byQ96/Scorpio-recruit/sprawozdanie/spr.pdf

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

## 1 Wst¦p

Jestem studentem III roku Automatyki i Robotyki na wydziale Elektroniki, interesuj¦ si¦ motoryzacj¡, elektronik¡, robotyk¡ oraz najnowszymi technologiami, np Przemysªem
4.0. Moim pierwszym projektem opartym na mikrokontrolerach byª system alarmowy oparty na czujnikach PIR. Braªem udziaª w warsztatach robotycznych organizowanych przez KoNaR, podj¡ªem si¦ budowy robota MiniSumo, odkªadana w czasie budowa niedawno zako«czyªa si¦ sukcesem. Od roku uczestnicz¦ w KN EKSA, gdzie grupowo realizuj¦ projekt Systemu Detekcji Wyªadowa« Atmosferycznych, gdzie do przetwarzania danych i komunikacj¡ z serwerem u»ywamy pªytki Nucleo z procesorem STM32. Na co dzie« du»o zajmuj¦ si¦ elektronik¡ i bardzo interesuje mnie Wasz projekt ªazika, dlatego chciaªbym si¦ sta¢ jednym z jego twórców.

## 2 Realizacja

Podj¡ªem si¦ realizacji zadania 2. dla elektroników/programistów. Czyli zaprojektowania schematu i pªytki PCB zgodnie z wytycznymi.

### 2.1 Schemat ukªadu

Omawianie schematu pozwol¦ sobie rozdzieli¢ na kilka cz¦±ci, zgodnie z wytycznymi i wªasnymi spostrze»eniami.
Sercem prototypu pªytki jest 100 nó»kowy procesor STM32F107V C. Wybraªem go z powodu mo»liwo±ci obsªugi systemu wymiany danych CAN oraz ETHERNET'u.

2.1.1 Podstawowe rzeczy

Przyj¡ªem »e ukªad b¦dzie zasilany warto±ci¡ 12V. Oczywi±cie warto±¢ t¡ mo»na zmieni¢, jednak maksymalna warto±¢ napi¦cia wej±ciowego nie powinna przekracza¢ 15V. Nie dodaªem »adnego zabezpieczenia elektronicznego przed odwrotn¡ polaryzacj¡, zast¡piªem je zabezpieczeniem mechanicznym - gniazdo zasilania jack. Dodaªem zielon¡ diod¦ zasilania, oraz przycisk do resetu ukªadu.

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



2.1.3 IMU

Zdecydowaªem si¦ na poªo»enie ukªadu LSM9DS1 bezpo±rednio na pªytce. Uwa»am, »e niew¡tpliw¡ przewag¡ takiego rozwi¡zania jest stabilno±¢ ukªadu i lepsza dokªadno±¢ wskaza« ni» przy zastosowaniu gotowej pªytki z moduªem do wlutowania, która mo»e nie by¢ wystarczaj¡co sztywna i zakªamywa¢ wskazania. Jak wida¢ na schemacie czujnik posiada mo»liwo±¢ zmiany adresu akcelerometru/»yroskopu oraz magnetometru. (ustawiaj¡c odpowiednio zwork¦ mo»emy ªatwo wyª¡czy¢ z dziaªania który± z moduªów. Moduª podª¡czony jest do mikroprocesora za po±rednictwem magistrali I2C.

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

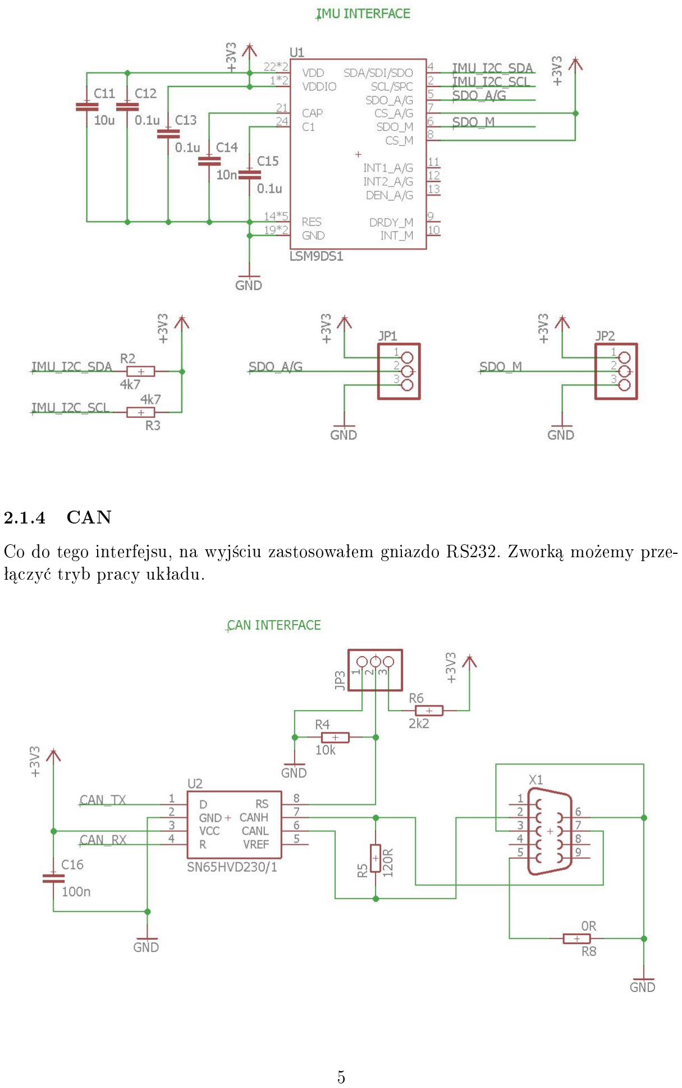
[picture p18: page 5]

2.1.5 Enkoder Absolutny

Sporo czasu zaj¦ªo mi wybranie odpowiedniego interfejsu, na pocz¡tku chciaªem podª¡-czy¢ enkoder na przerwania, jednak ostatecznie zdecydowaªem si¦ na poª¡czenie po SPI. Zalet¡ takiego rozwi¡zania jest mo»liwo±¢ podª¡czenia kilku enkoderów do tej samej linii danych. Gniazdo jakie wyprowadziªem to 6-pinowy goldpin ustawiony pod k¡tem prostym, pasuje on do enkoderów absolutnych marki Bourns, model:EMS22A, który zostaª zaprojektowany dla zasilania 3.3V, ale b¦dzie pracowaª prawidªowo równie» z innymi enkoderami z mo»liwo±ci¡ obsªugi SPI.


2.1.6 Ethernet

Ten moduª jest najbardziej rozbudowany. Do budowy schematu u»yªem ukªadu DP83848, wzorowaªem si¦ natomiast na gotowym module ZL3ET H. Ukªad posiada oddzieln¡ ltracj¦ zasilania, kwarc taktuj¡cy zegarem 25MHz, który mo»na zmieni¢ w zale»no±ci od typu u»ywanej transmisji. Na wyj±ciu ukªadu znajduje si¦ gniazdo RJ-45 z dwoma diodami stanu, które pokazuj¡ wysyªanie/odbieranie danych.


2.1.7 Fototranzystor, dioda IR, dioda LED, gniazdo programatora

Fototranzystor podª¡czyªem do wej±cia ADC1 mikroprocesora, próbkuj¡cego sygnaª analogowy. Dioda IR podª¡czona pod gniazdo z obsªug¡ PWM. Tak samo równie» zwykªa dioda LED stanu podª¡czona pod generator PWM. Nie wiem czy dobrze zrozumiaªem zadanie, ale wszystkie 3 elementy usytuowane s¡ w jednym miejscu na pªytce. Diod¦ IR mo»na wi¦c ustawi¢ nad fototranzystorem, tranzystor jako sprz¦»enie zwrotne b¦dzie generowaª sygnaª PWM na diodzie LED. Wi¦c teoretycznie sygnaª PWM na diodzie LED powinien odpowiada¢ temu wygenerowanemu na diodzie IR.
Gniazdo programatora jest dodatkiem ode mnie. Stwierdziªem i» dodanie zwykªego goldpinu mogªoby by¢ do±¢ uci¡»liwe przy ci¡gªym wpinaniu i wypinaniu wtyczki, dlatego zastosowaªem gniazdo miniUSB.


2.1.8 Przyciski i diody LED

Poniewa» przy mikroprocesorze zostaªo sporo wolnych pinów zdecydowaªem o umieszczeniu dodatkowych 3 przycisków oraz 3 diód LED w kolorach (zielonym, »óªtym, czerwonym). Mog¡ si¦ one przyda¢ np. do pokazywania ró»nych stanów pªytki, usterek czy awarii, natomiast przyciski do zmieniania ustawie«.

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


### 2.2 Projekt PCB

Zaprojektowana przeze mnie pªytka jest dwuwarstwowa. W projekcie u»yªem opcji Autoroutera, który poprowadziª dla mnie ±cie»ki w 80 procentach, reszt¦ naniosªem r¦cznie. Wersja studencka programu, której u»ywaªem, nie pozwalaªa na zwi¦kszenie wymiarów obszaru roboczego powy»ej 10 cm x 8 cm. cie»ki zasilania s¡ pogrubione, elementy ltruj¡ce staraªem si¦ umieszcza¢ jak najbli»ej ukªadów scalonych.


Rysunek 1: Górna warstwa

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



Rysunek 3: Poª¡czenie warstw

Poni»ej wstawiam zdj¦cia prototypu w 3D, jakby to wygª¡daªo wizualnie po zªo»eniu, na spodzie znajduje si¦ tylko kilka elementów, które przeszkadzaªy na górnej warstwie.

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

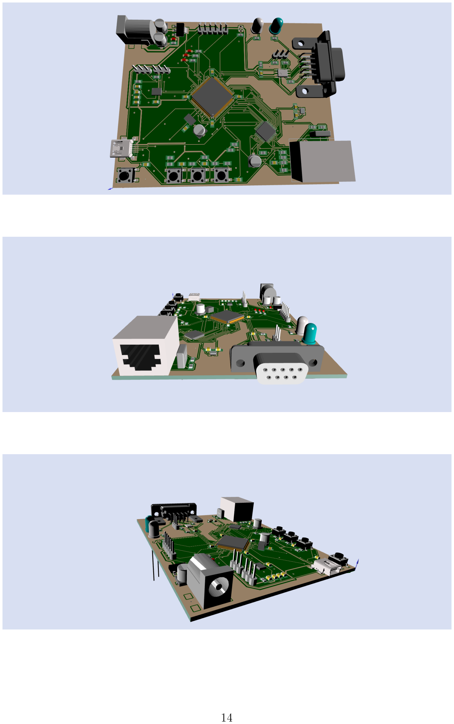
[picture p19: page 14]

### 2.3 Programowanie i prototyp

Poni»szy rysunek przedstawia konguracj¦ portów w programie Cube MX, do programowania u»yªbym biblioteki HAL.


## 3 Podsumowanie

Do sprawozdania zaª¡czam archiwum, w którym znajduj¡ si¦ elementy projektu - schemat poª¡cze« i projekt pªytki w formacie EAGLE'a, a tak»e biblioteki których u»ywaªem przy projektowaniu. Z racji braku czasu prototyp oraz programowanie pªytki s¡ kwesti¡ niedoko«czon¡. W razie potrzeby kontaktu ze mn¡ na temat projektu prosz¦ o kontakt pod poni»szy adres e-mail: michal126@hotmail.com.
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
