byQ96/Scorpio-recruit/sprawozdanie/figures/screenshot (2).png

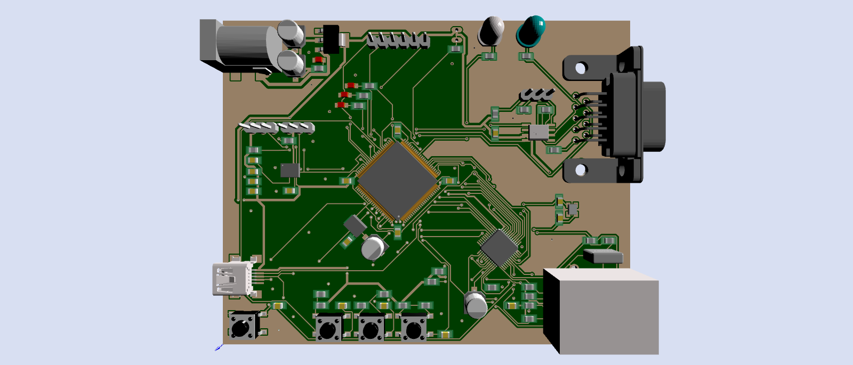
sprawozdanie/figures/screenshot (2).png
