byQ96/Scorpio-recruit/eagle/schemat1.brd

## EAGLE design eagle/schemat1.brd (2017-11-30)

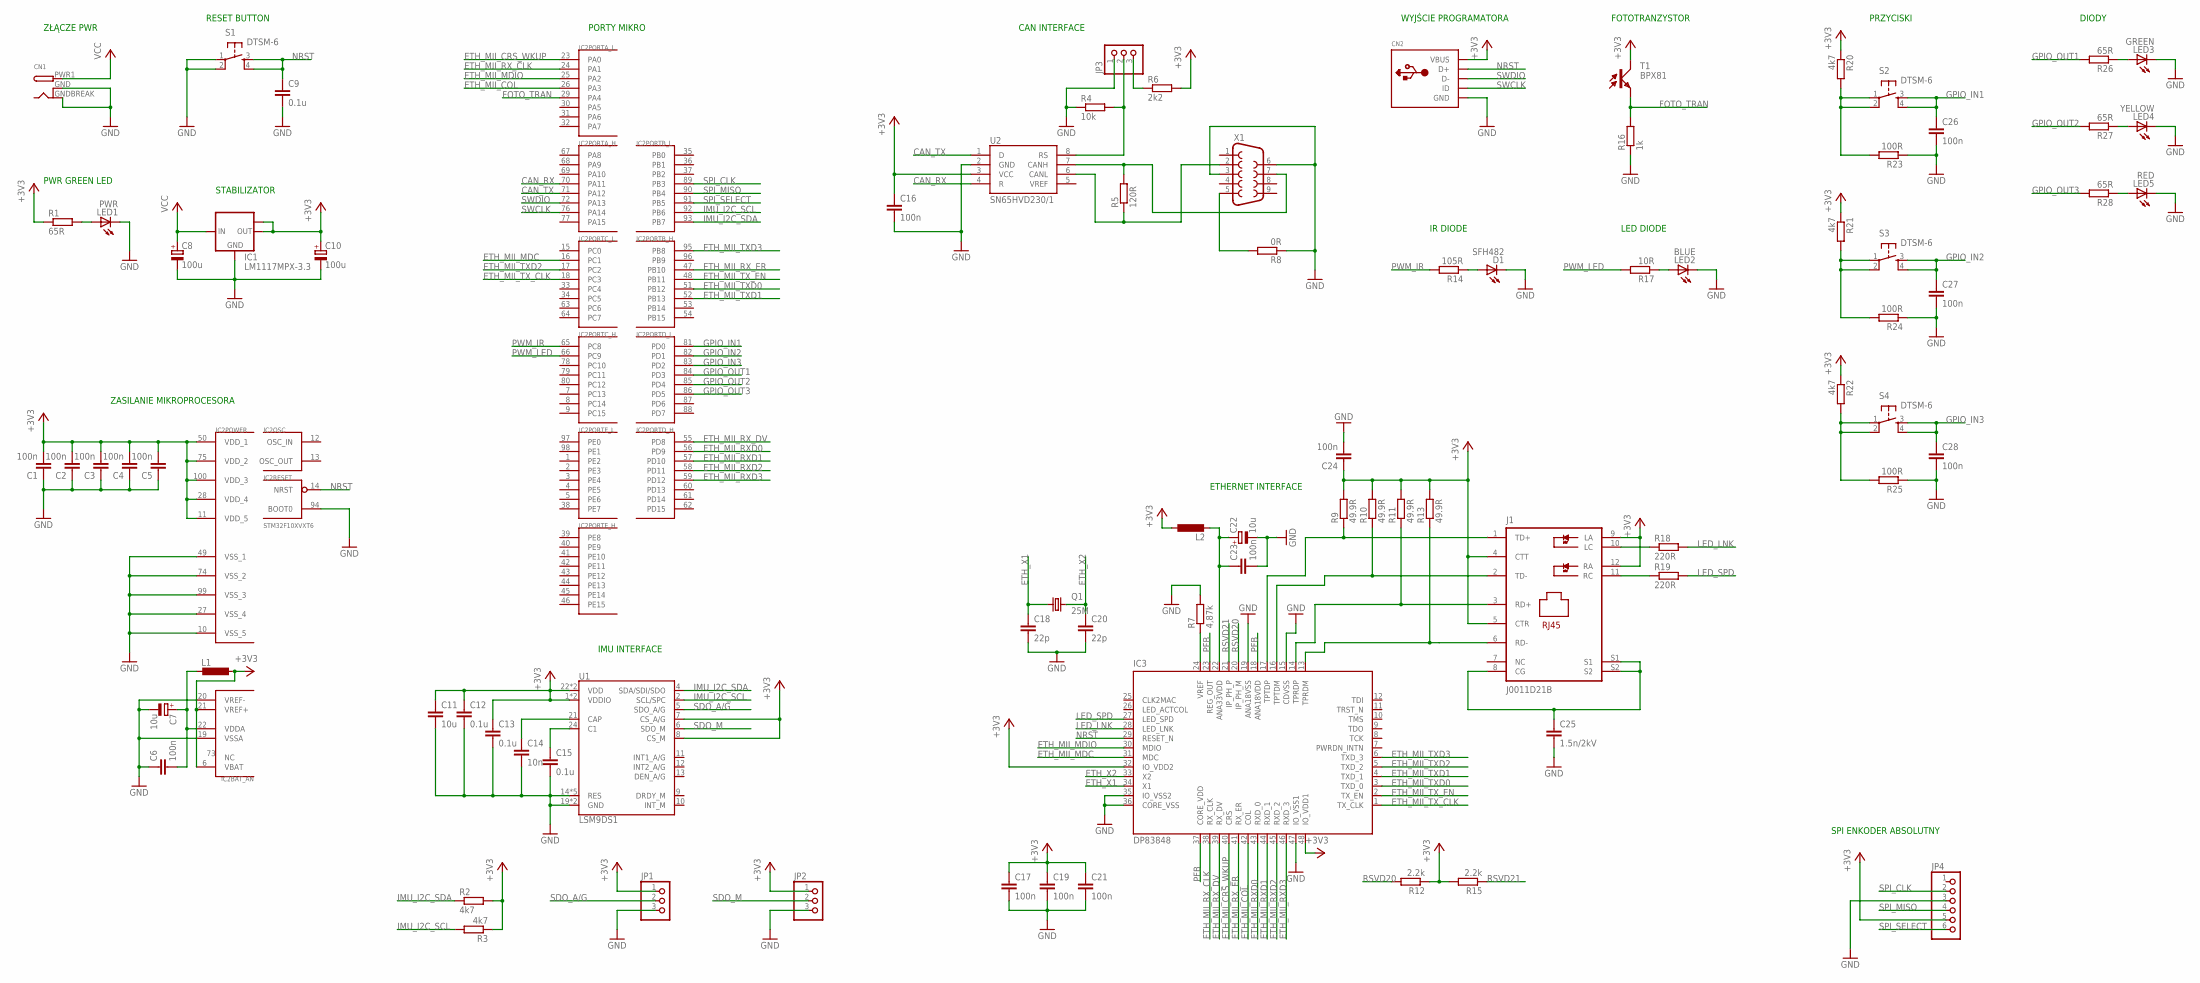
[picture p21: schematic schemat1.sch]

Parts:
C1, C2, C3, C4, C5, C6, C16, C17, C19, C21, C23, C24, C26, C27, C28: 100n; C0805
C7, C22: 10u; PANASONIC_C
C8, C10: 100u; PANASONIC_C
C9, C12, C13, C15: 0.1u; C0805
C11: 10u; C0805
C14: 10n; C0805
C18, C20: 22p; C0805
C25: 1.5n/2kV; C050-030X075
CN1: DCBARRELSMT; DCJACK_2MM_SMT
CN2: USBMINIB; USB-MINIB
D1: SFH482
IC1: LM1117MPX-3.3; SOT223
IC2: STM32F10XVXT6; TQFP100
IC3: DP83848; LQFP48
J1: J0011D21B; J0-A/B/F
JP1, JP2, JP3: PINHD-1X3; 1X03
JP4: PINHD-1X6/90; 1X06/90
L1, L2: L-EUL3230M; L3230M
LED1: PWR; CHIPLED_0805
LED2: BLUE; LED5MM
LED3: GREEN; CHIPLED_0805
LED4: YELLOW; CHIPLED_0805
LED5: RED; CHIPLED_0805
Q1: 25M; 3.2X2.5_KX-7
R1: 65R; R0805
R2, R3: 4k7; M0805
R4: 10k; M0805
R5: 120R; M0805
R6: 2k2; M0805
R7: 4,87k; R0805
R8: 0R; R0805
R9, R10, R11, R13: 49.9R; R0805
R12, R15: 2.2k; R0805
R14: 105R; M0805
R16: 1k; R0805
R17: 10R; M0805
R18, R19: 220R; R0805
R20, R21, R22: 4k7; R0805
R23, R24, R25: 100R; R0805
R26, R27, R28: 65R; M0805
S1, S2, S3, S4: DTSM-6
T1: BPX81
U1: LSM9DS1; LGA24-8X4
U2: SN65HVD230/1; SO8
X1: F09HP

Connections:
+3V3: C1.2, C2.2, C3.2, C4.2, C5.2, C10.+, C11.1, C12.1, C13.1, C16.1, C17.1, C19.1, C21.1, C24.1, CN2.VBUS, IC1.2 (OUT), IC1.TAB (OUT1), IC2.6 (VBAT), IC2.11 (VDD_5), IC2.21 (VREF+), IC2.28 (VDD_4), IC2.50 (VDD_1), IC2.75 (VDD_2), IC2.100 (VDD_3), IC3.32 (IO_VDD2), IC3.48 (IO_VDD1), J1.4 (CTT), J1.5 (CTR), J1.9 (LA), J1.12 (RA), JP1.1, JP2.1, JP4.5, L1.1, L2.1, R1.1, R2.2, R3.1, R6.2, R9.2, R10.2, R11.2, R12.1, R13.2, R15.2, R20.1, R21.1, R22.1, T1.C, U1.1 (VDDIO), U1.3 (VDDIO), U1.7 (CS_A/G), U1.8 (CS_M), U1.22 (VDD), U1.23 (VDD), U2.3 (VCC)
CAN_RX: IC2.70 (PA11), U2.4 (R)
CAN_TX: IC2.71 (PA12), U2.1 (D)
ETH_MII_COL: IC2.26 (PA3), IC3.42 (COL)
ETH_MII_CRS_WKUP: IC2.23 (PA0), IC3.40 (CRS)
ETH_MII_MDC: IC2.16 (PC1), IC3.31 (MDC)
ETH_MII_MDIO: IC2.25 (PA2), IC3.30 (MDIO)
ETH_MII_RXD0: IC2.56 (PD9), IC3.43 (RXD_0)
ETH_MII_RXD1: IC2.57 (PD10), IC3.44 (RXD_1)
ETH_MII_RXD2: IC2.58 (PD11), IC3.45 (RXD_2)
ETH_MII_RXD3: IC2.59 (PD12), IC3.46 (RXD_3)
ETH_MII_RX_CLK: IC2.24 (PA1), IC3.38 (RX_CLK)
ETH_MII_RX_DV: IC2.55 (PD8), IC3.39 (RX_DV)
ETH_MII_RX_ER: IC2.47 (PB10), IC3.41 (RX_ER)
ETH_MII_TXD0: IC2.51 (PB12), IC3.3 (TXD_0)
ETH_MII_TXD1: IC2.52 (PB13), IC3.4 (TXD_1)
ETH_MII_TXD2: IC2.17 (PC2), IC3.5 (TXD_2)
ETH_MII_TXD3: IC2.95 (PB8), IC3.6 (TXD_3)
ETH_MII_TX_CLK: IC2.18 (PC3), IC3.1 (TX_CLK)
ETH_MII_TX_EN: IC2.48 (PB11), IC3.2 (TX_EN)
ETH_X1: C18.1, IC3.34 (X1), Q1.1
ETH_X2: C20.1, IC3.33 (X2), Q1.3 (2)
FOTO_TRAN: IC2.29 (PA4), R16.2, T1.E
GND: C1.1, C2.1, C3.1, C4.1, C5.1, C6.1, C7.-, C8.-, C9.2, C10.-, C11.2, C12.2, C13.2, C14.2, C15.2, C16.2, C17.2, C18.2, C19.2, C20.2, C21.2, C22.-, C23.2, C24.2, C25.2, C26.2, C27.2, C28.2, CN1.GND (GNDBREAK), CN1.GNDBREAK (GND), CN2.GND, D1.K (C), IC1.1 (GND), IC2.10 (VSS_5), IC2.19 (VSSA), IC2.20 (VREF-), IC2.27 (VSS_4), IC2.49 (VSS_1), IC2.74 (VSS_2), IC2.94 (BOOT0), IC2.99 (VSS_3), IC3.15 (CDVSS), IC3.19 (ANA18VSS), IC3.35 (IO_VSS2), IC3.36 (CORE_VSS), IC3.47 (IO_VSS1), JP1.3, JP2.3, JP3.1, JP4.3, LED1.C, LED2.K (C), LED3.C, LED4.C, LED5.C, R4.1, R7.2, R8.1, R16.1, R23.1, R24.1, R25.1, S1.1, S1.2, U1.14 (RES), U1.15 (RES), U1.16 (RES), U1.17 (RES), U1.18 (RES), U1.19 (GND), U1.20 (GND), U2.2 (GND), X1.3, X1.6
GPIO_IN1: C26.1, IC2.81 (PD0), S2.3, S2.4
GPIO_IN2: C27.1, IC2.82 (PD1), S3.3, S3.4
GPIO_IN3: C28.1, IC2.83 (PD2), S4.3, S4.4
GPIO_OUT1: IC2.84 (PD3), R26.2
GPIO_OUT2: IC2.85 (PD4), R27.2
GPIO_OUT3: IC2.86 (PD5), R28.2
IMU_I2C_SCL: IC2.92 (PB6), R3.2, U1.2 (SCL/SPC)
IMU_I2C_SDA: IC2.93 (PB7), R2.1, U1.4 (SDA/SDI/SDO)
LED_LNK: IC3.28 (LED_LNK), R18.2
LED_SPD: IC3.27 (LED_SPD), R19.2
unnamed: IC3.13 (TPRDM), J1.6 (RD-), R13.1
unnamed: R8.2, X1.5
unnamed: R5.1, U2.6 (CANL), X1.2
unnamed: JP3.2, R4.2, U2.8 (RS)
unnamed: R5.2, U2.7 (CANH), X1.7
unnamed: JP3.3, R6.1
unnamed: IC3.14 (TPRDP), J1.3 (RD+), R11.1
unnamed: IC3.16 (TPTDM), J1.2 (TD-), R10.1
unnamed: IC3.24 (VREF), R7.1
unnamed: IC3.17 (TPTDP), J1.1 (TD+), R9.1
unnamed: C6.2, C7.+, IC2.22 (VDDA), L1.2
unnamed: LED1.A, R1.2
unnamed: J1.10 (LC), R18.1
unnamed: J1.11 (RC), R19.1
unnamed: C15.1, U1.24 (C1)
unnamed: C14.1, U1.21 (CAP)
unnamed: D1.A, R14.1
unnamed: LED2.A, R17.1
unnamed: C25.1, J1.8 (CG), J1.S1, J1.S2
unnamed: R20.2, R23.2, S2.1, S2.2
unnamed: R21.2, R24.2, S3.1, S3.2
unnamed: R22.2, R25.2, S4.1, S4.2
unnamed: LED3.A, R26.1
unnamed: C22.+, C23.1, IC3.22 (ANA33VDD), L2.2
unnamed: LED4.A, R27.1
unnamed: LED5.A, R28.1
NRST: C9.1, CN2.D+, IC2.14 (NRST), IC3.29 (RESET_N), S1.3, S1.4
PFB: IC3.18 (ANA18VDD), IC3.23 (REG_OUT), IC3.37 (CORE_VDD)
PWM_IR: IC2.65 (PC8), R14.2
PWM_LED: IC2.66 (PC9), R17.2
RSVD20: IC3.20 (IP_PH_M), R12.2
RSVD21: IC3.21 (IP_PH_P), R15.1
SDO_A/G: JP1.2, U1.5 (SDO_A/G)
SDO_M: JP2.2, U1.6 (SDO_M)
SPI_CLK: IC2.89 (PB3), JP4.2
SPI_MISO: IC2.90 (PB4), JP4.4
SPI_SELECT: IC2.91 (PB5), JP4.6
SWCLK: CN2.ID, IC2.76 (PA14)
SWDIO: CN2.D-, IC2.72 (PA13)
VCC: C8.+, CN1.PWR1 (PWR), IC1.3 (IN)

Notes on the sheet:
STABILIZATOR
ZASILANIE MIKROPROCESORA
WYJŚCIE PROGRAMATORA
CAN INTERFACE
ETHERNET INTERFACE
IMU INTERFACE
RESET BUTTON
ZŁĄCZE PWR
PWR GREEN LED
PORTY MIKRO
IR DIODE
FOTOTRANZYSTOR
LED DIODE
SPI ENKODER ABSOLUTNY
PRZYCISKI
DIODY

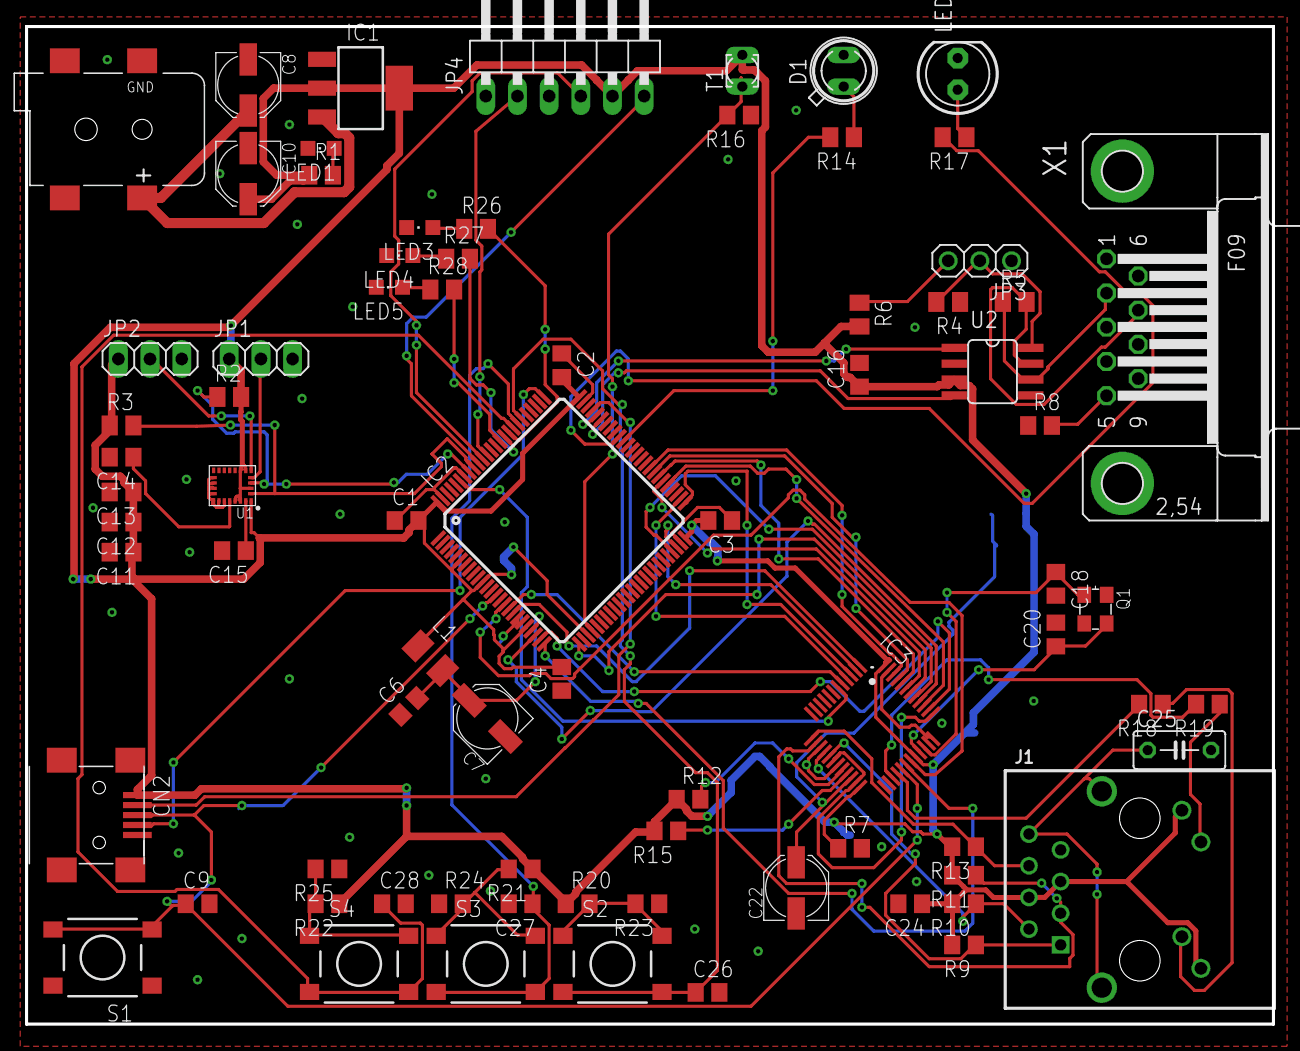
[picture p22: board schemat1.brd from above]

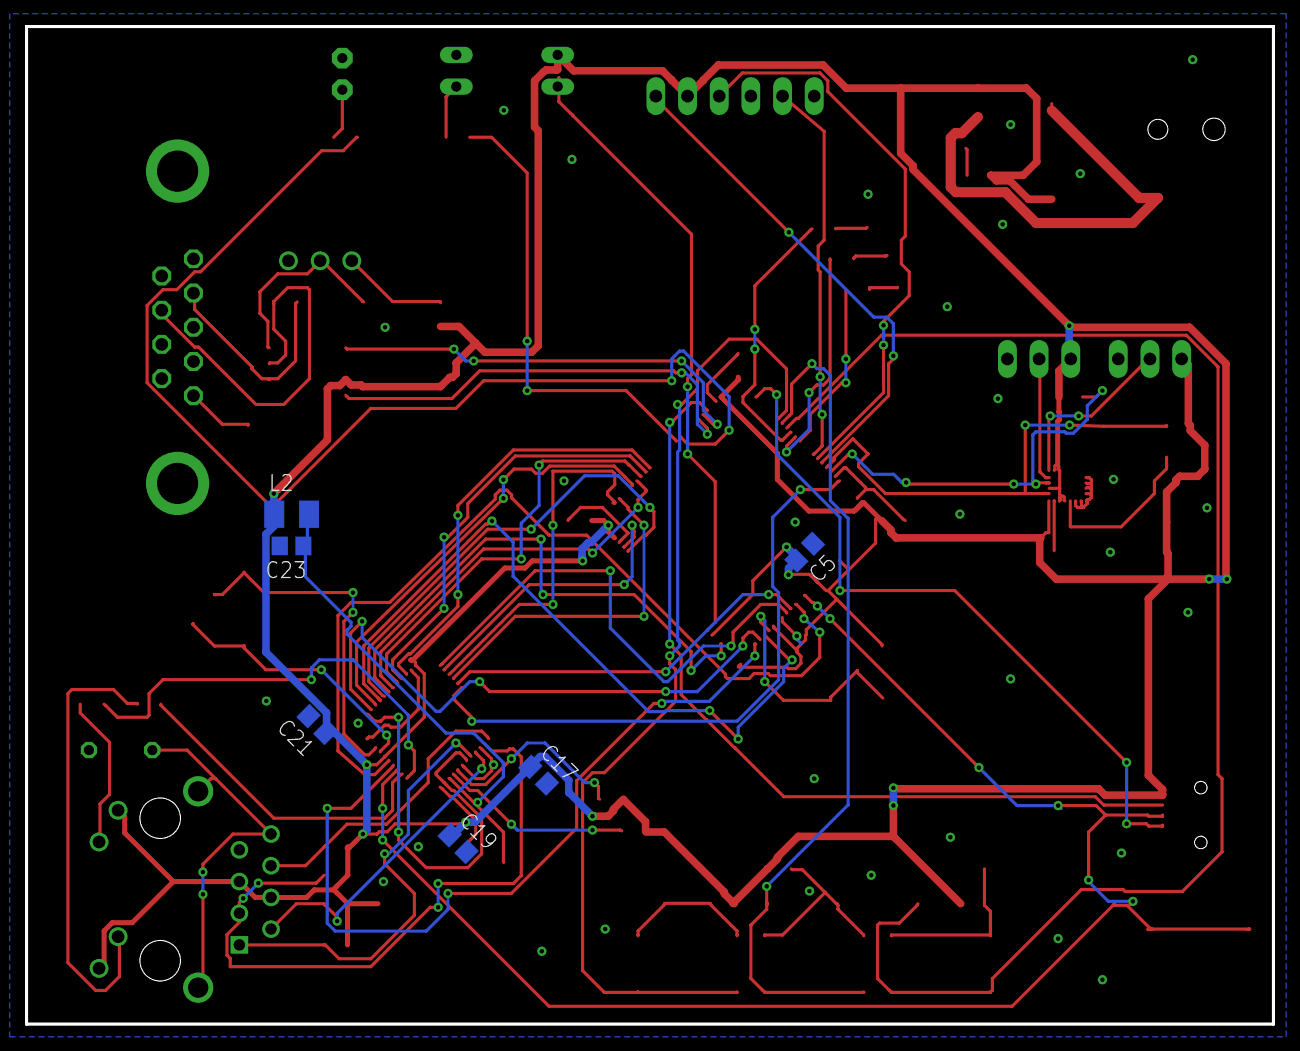
[picture p23: board schemat1.brd from below]

Board: 2 copper layers, 100.0 x 80.0 mm, 83 parts (6 on the bottom side), 74 nets.
