byQ96/Scorpio-recruit/sprawozdanie/prog.ioc

Mcu.UserName=STM32F107VCTx
PA0-WKUP.Signal=ETH_CRS
PA1.Signal=ETH_RX_CLK
PA11.Signal=CAN1_RX
PA12.Signal=CAN1_TX
PA2.Signal=ETH_MDIO
PA3.Signal=ETH_COL
PA4.GPIO_Label=FOTO_TRAN
PA4.Signal=ADCx_IN4
PB11.Signal=ETH_TX_EN
PB12.Signal=ETH_TXD0
PB13.Signal=ETH_TXD1
PB3.Signal=SPI1_SCK
PB4.Signal=SPI1_MISO
PB5.GPIO_Label=SPI1_SELECT
PB5.Signal=GPIO_Input
PB6.Signal=I2C1_SCL
PB7.Signal=I2C1_SDA
PB8.Signal=ETH_TXD3
PC1.Signal=ETH_MDC
PC2.Signal=ETH_TXD2
PC3.Signal=ETH_TX_CLK
PC8.GPIO_Label=PWM_IR
PC8.Signal=S_TIM3_CH3
PC9.GPIO_Label=PWM_LED
PC9.Signal=S_TIM3_CH4
PD0.GPIO_Label=GPIO_IN1
PD0.Signal=GPIO_Input
PD1.GPIO_Label=GPIO_IN2
PD1.Signal=GPIO_Input
PD10.Signal=ETH_RXD1
PD11.Signal=ETH_RXD2
PD12.Signal=ETH_RXD3
PD2.GPIO_Label=GPIO_IN3
PD2.Signal=GPIO_Input
PD3.GPIO_Label=GPIO_OUT1
PD3.Signal=GPIO_Output
PD4.GPIO_Label=GPIO_OUT2
PD4.Signal=GPIO_Output
PD5.GPIO_Label=GPIO_OUT3
PD5.Signal=GPIO_Output
PD8.Signal=ETH_RX_DV
PD9.Signal=ETH_RXD0
