byQ96/Scorpio-recruit/(notices)

Notices in the files:
parts and their libraries:
pulse-eng: Copyright (C) 2008, Bob Starr
crystal-geyer_V1_0: Copyright: Geyer-Electronic
